ShaunDyson/SIT210-FinalProject/Tests/EventTests/readme.txt

Before running any of these tests, replace the value for the ip_address variable
with the Raspberry Pi's IP Address

You must call the connect() function before running these tests.
