ShaunDyson/SIT210-FinalProject/Tests/SensorTest/readme.txt

Be sure to include the Adafruit_DHT library in the Particle app.
